NicoEFI/NicoEFI-ECU-Speeduino-mega2561/NicoEfi_GDRaceV1_Schematic_1-3.pdf

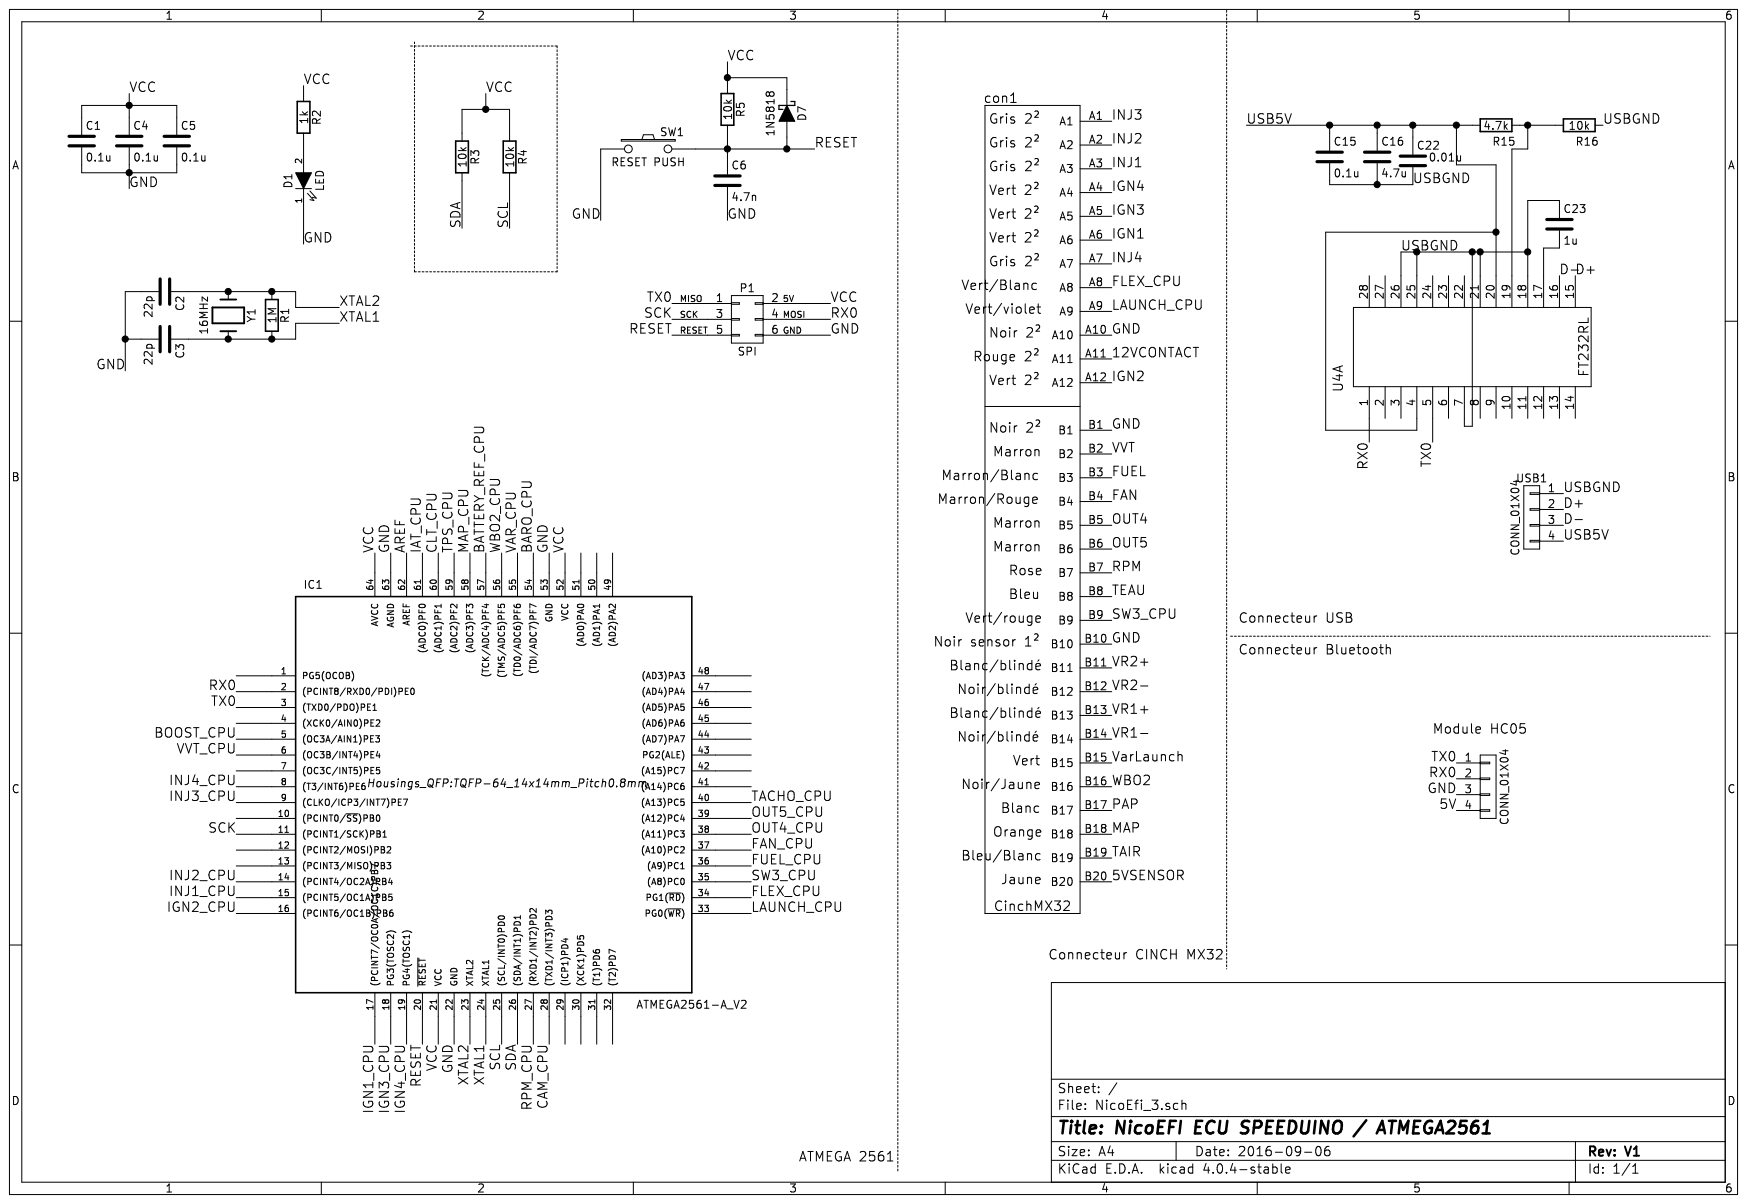
[picture p1: page 1]
