NicoEFI/NicoEFI-ECU-Speeduino-mega2561/NicoEfi_GDRaceV1_Schematic_2-3.pdf

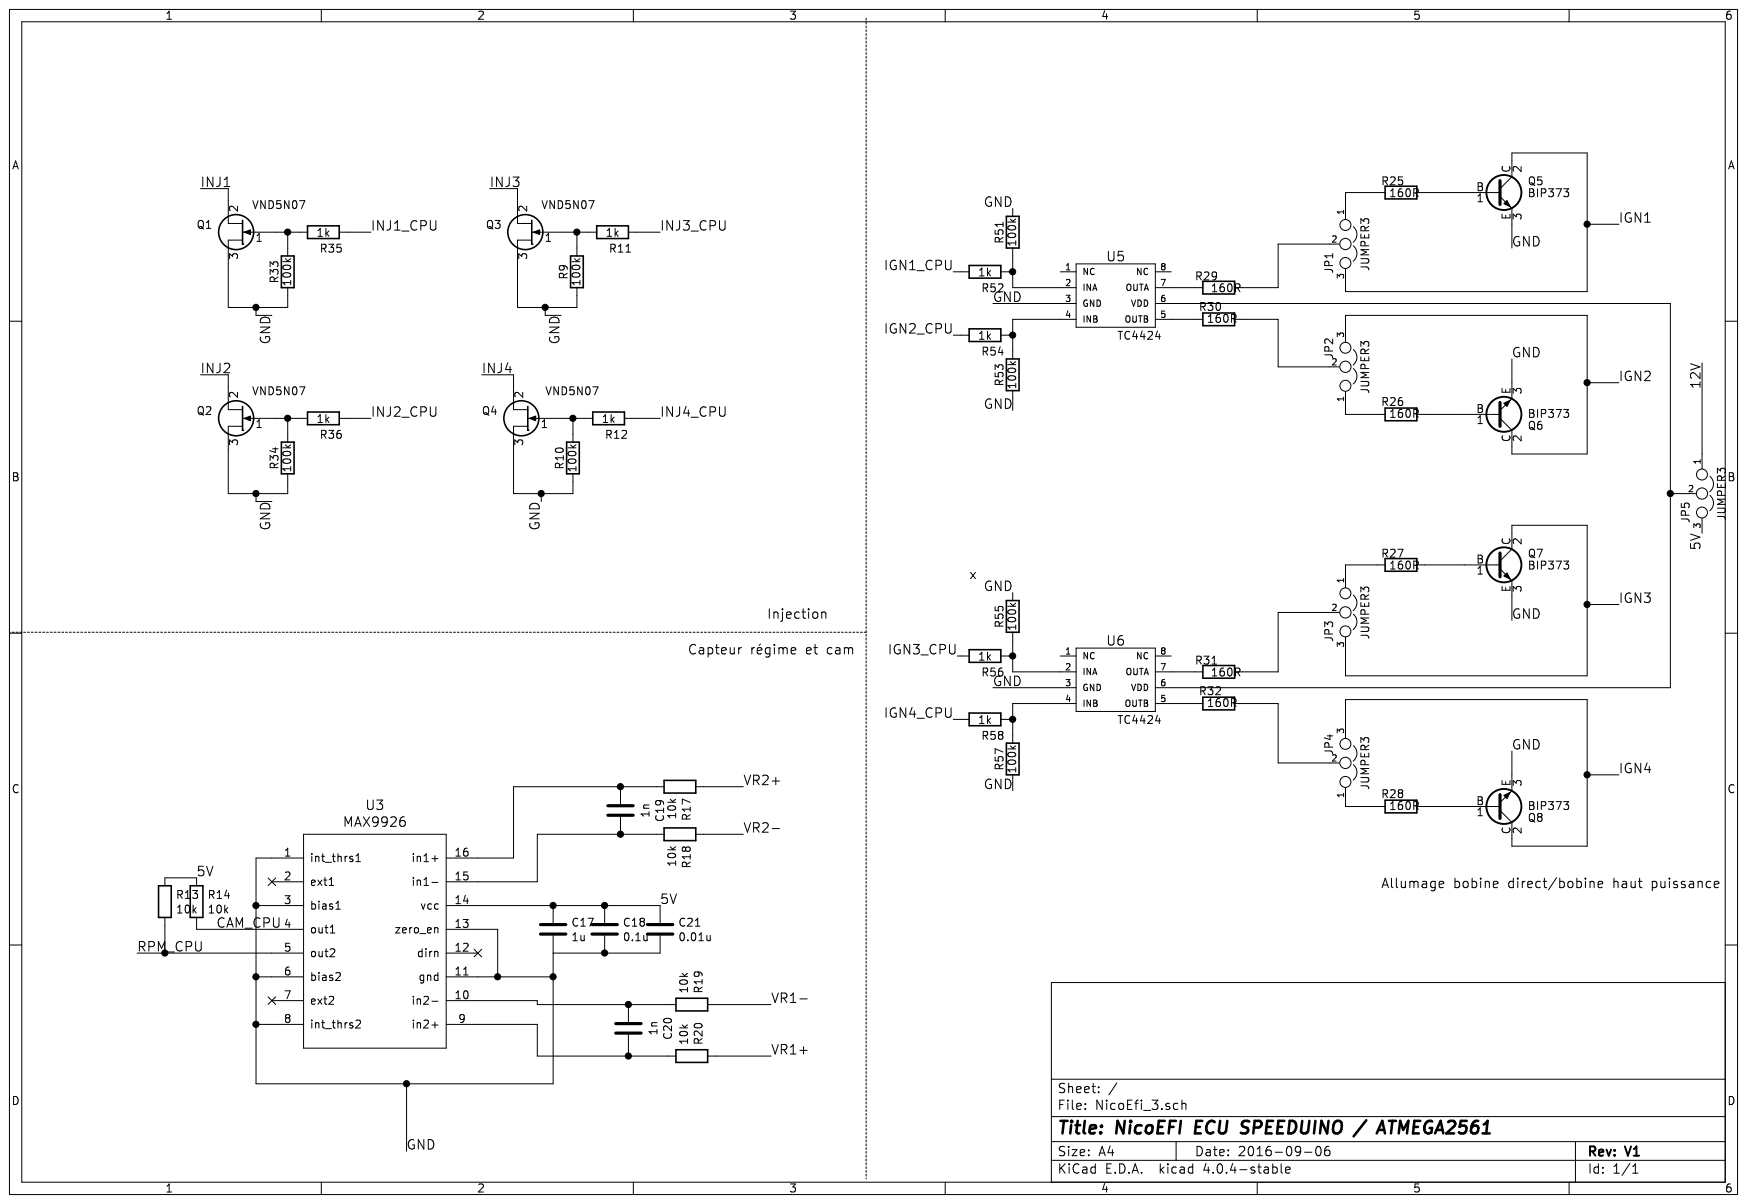
[picture p2: page 1]
