NicoEFI/NicoEFI-ECU-Speeduino-mega2561/NicoEfi_GDRaceV1_Schematic_3-3.pdf

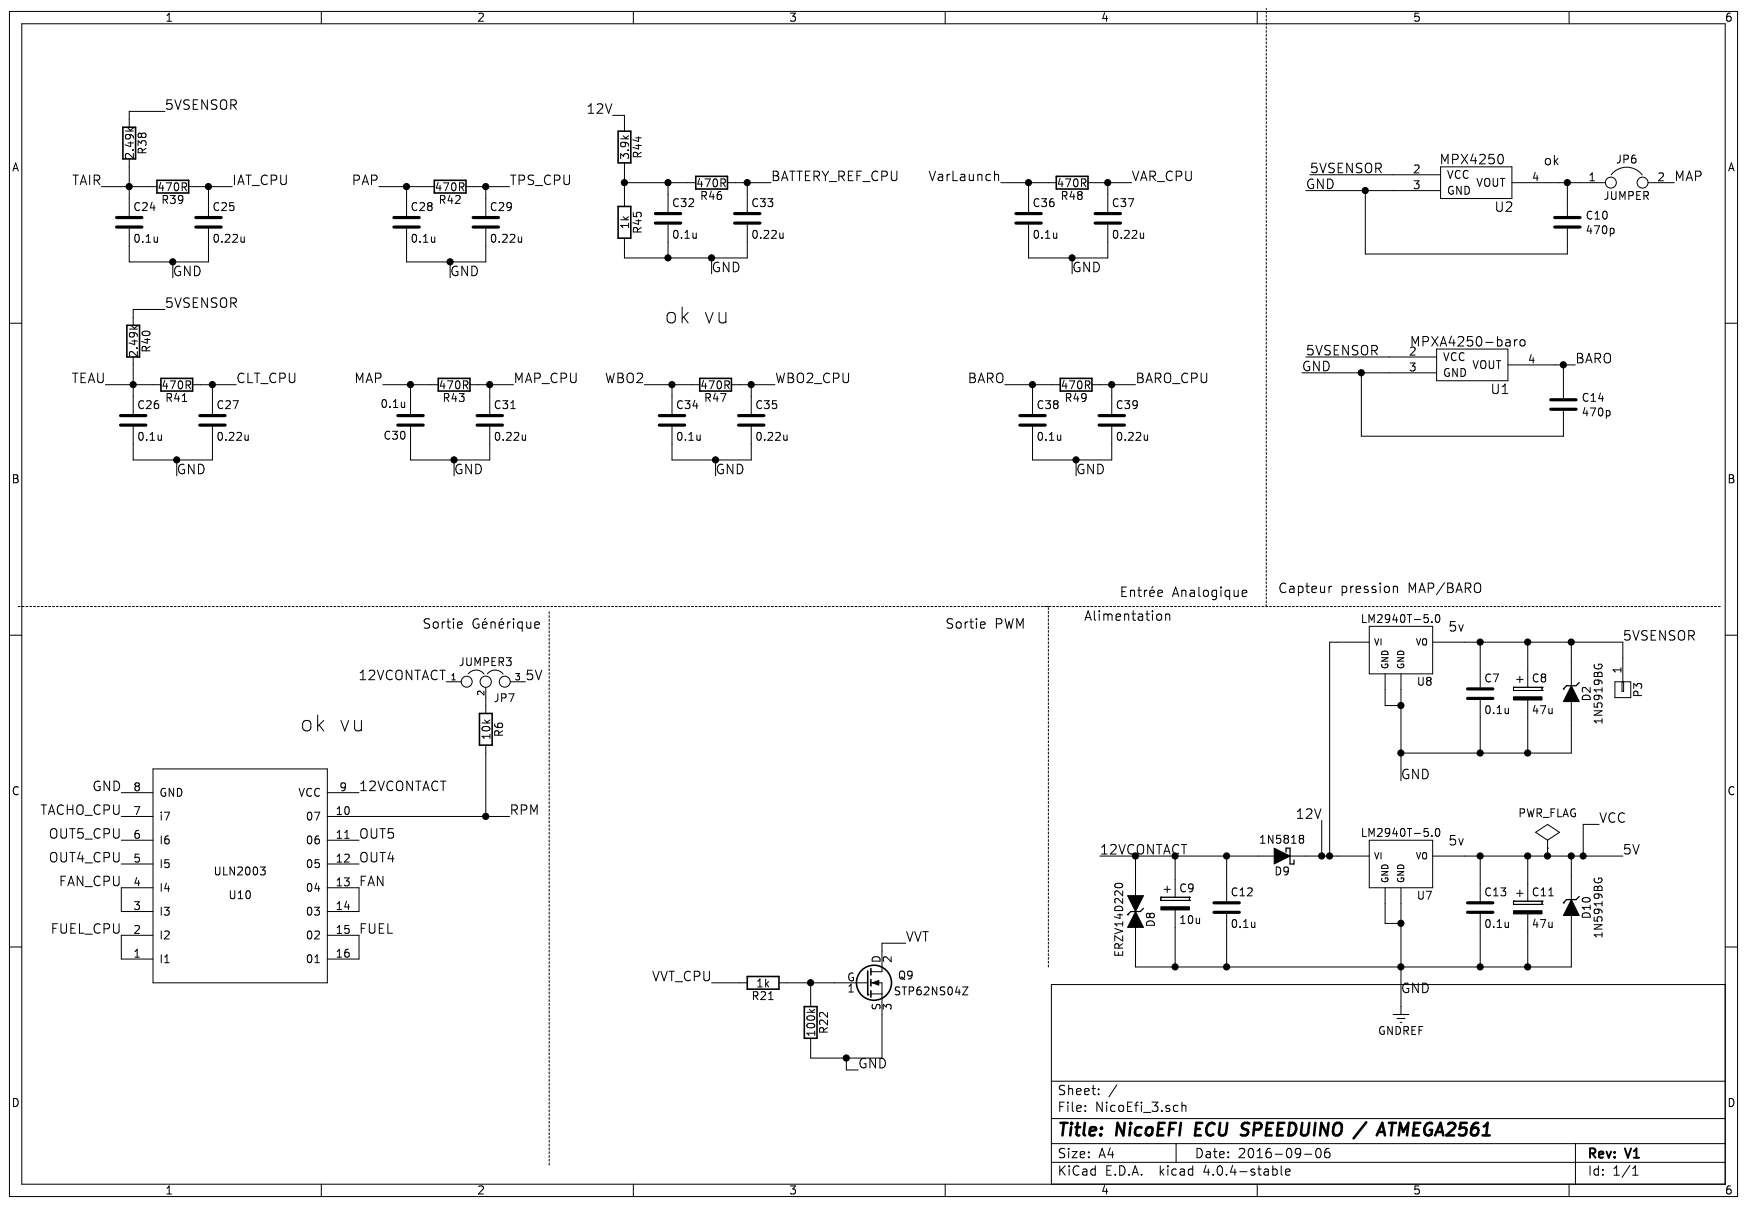
[picture p3: page 1]
