NicoEFI/NicoEFI-ECU-Speeduino-mega2561/NicoEfi_3.kicad_pcb

## KiCad design NicoEfi_3.kicad_pcb (2019-12-02)

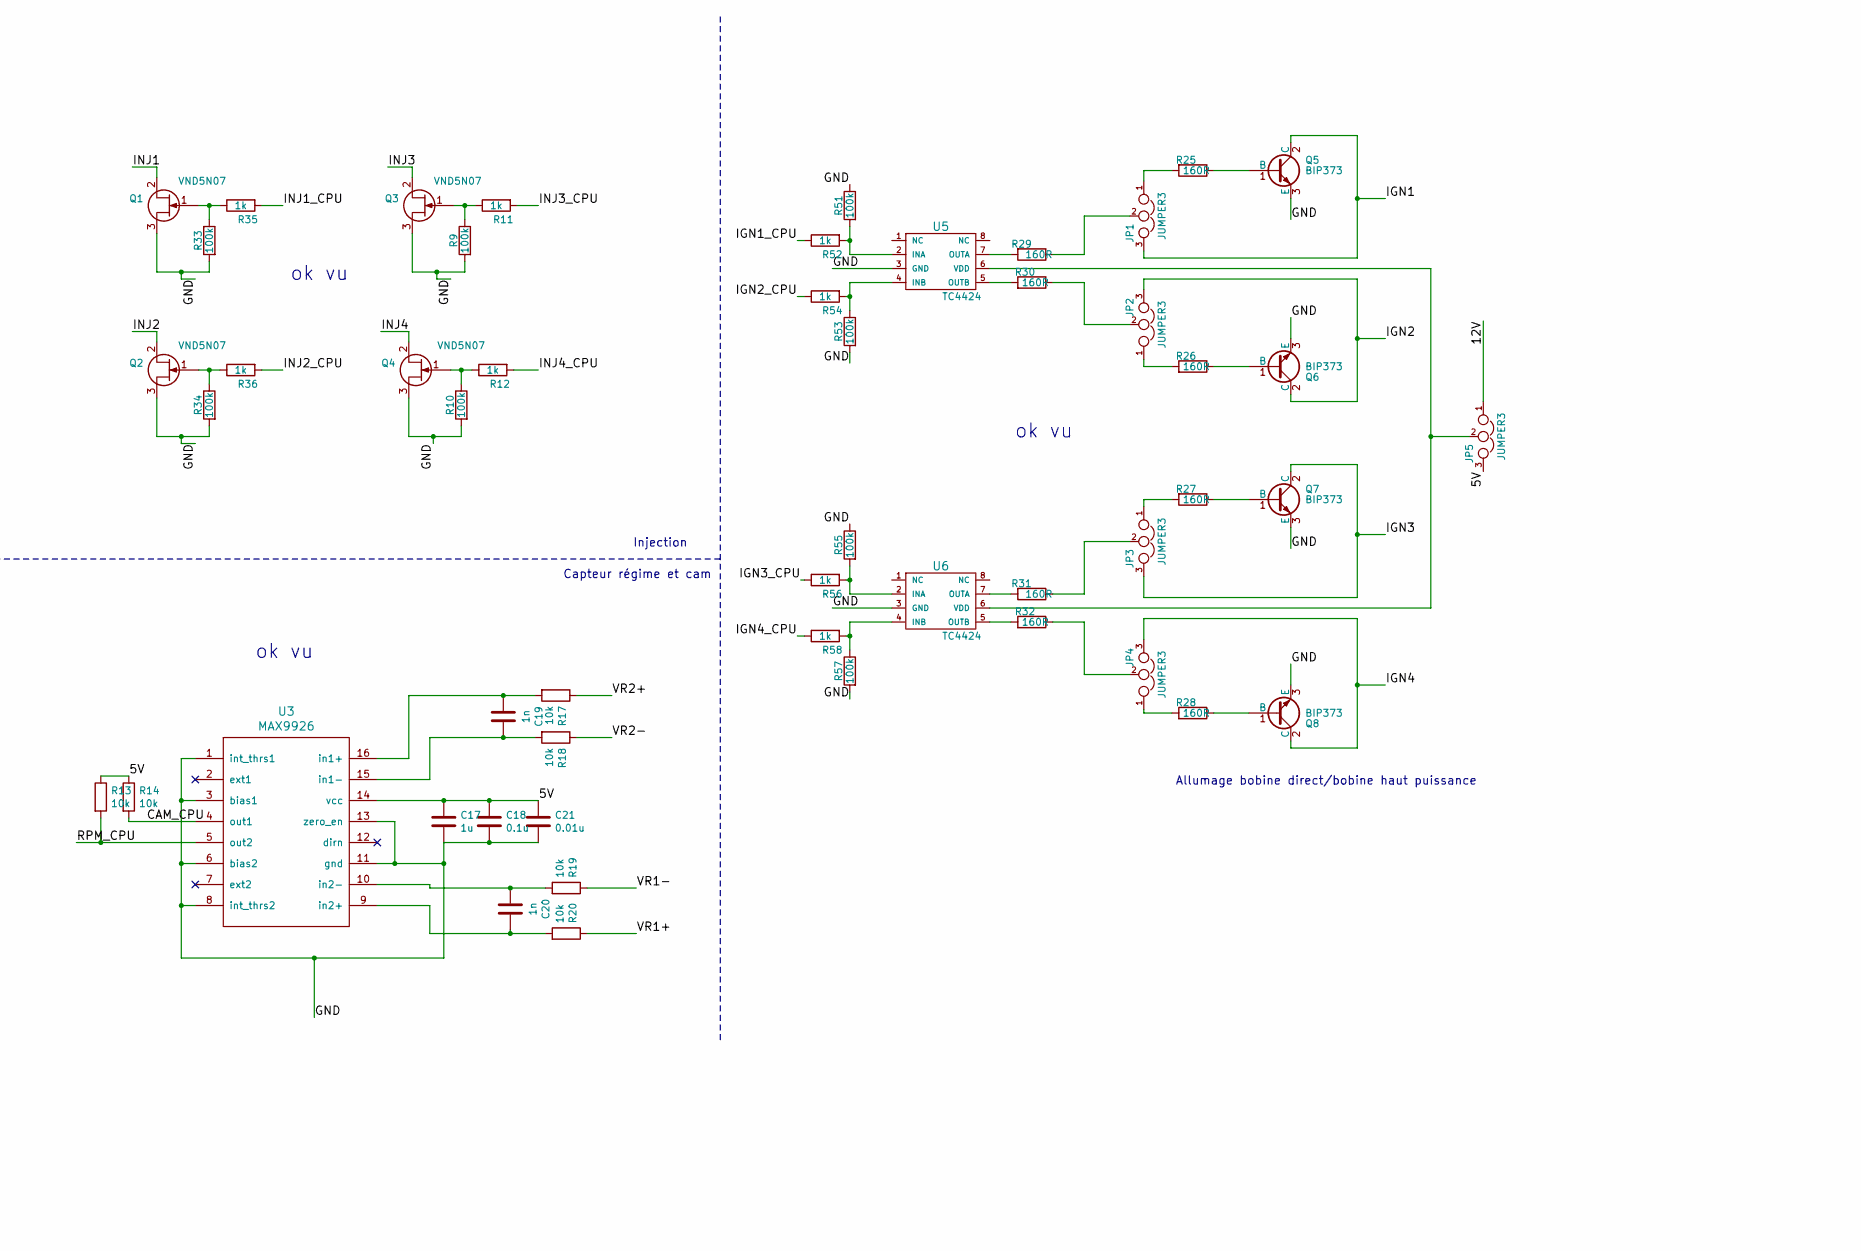
[picture p4: schematic NicoEfi_3.sch, NicoEFI ECU SPEEDUINO / ATMEGA2561, part in row 1, column 2]

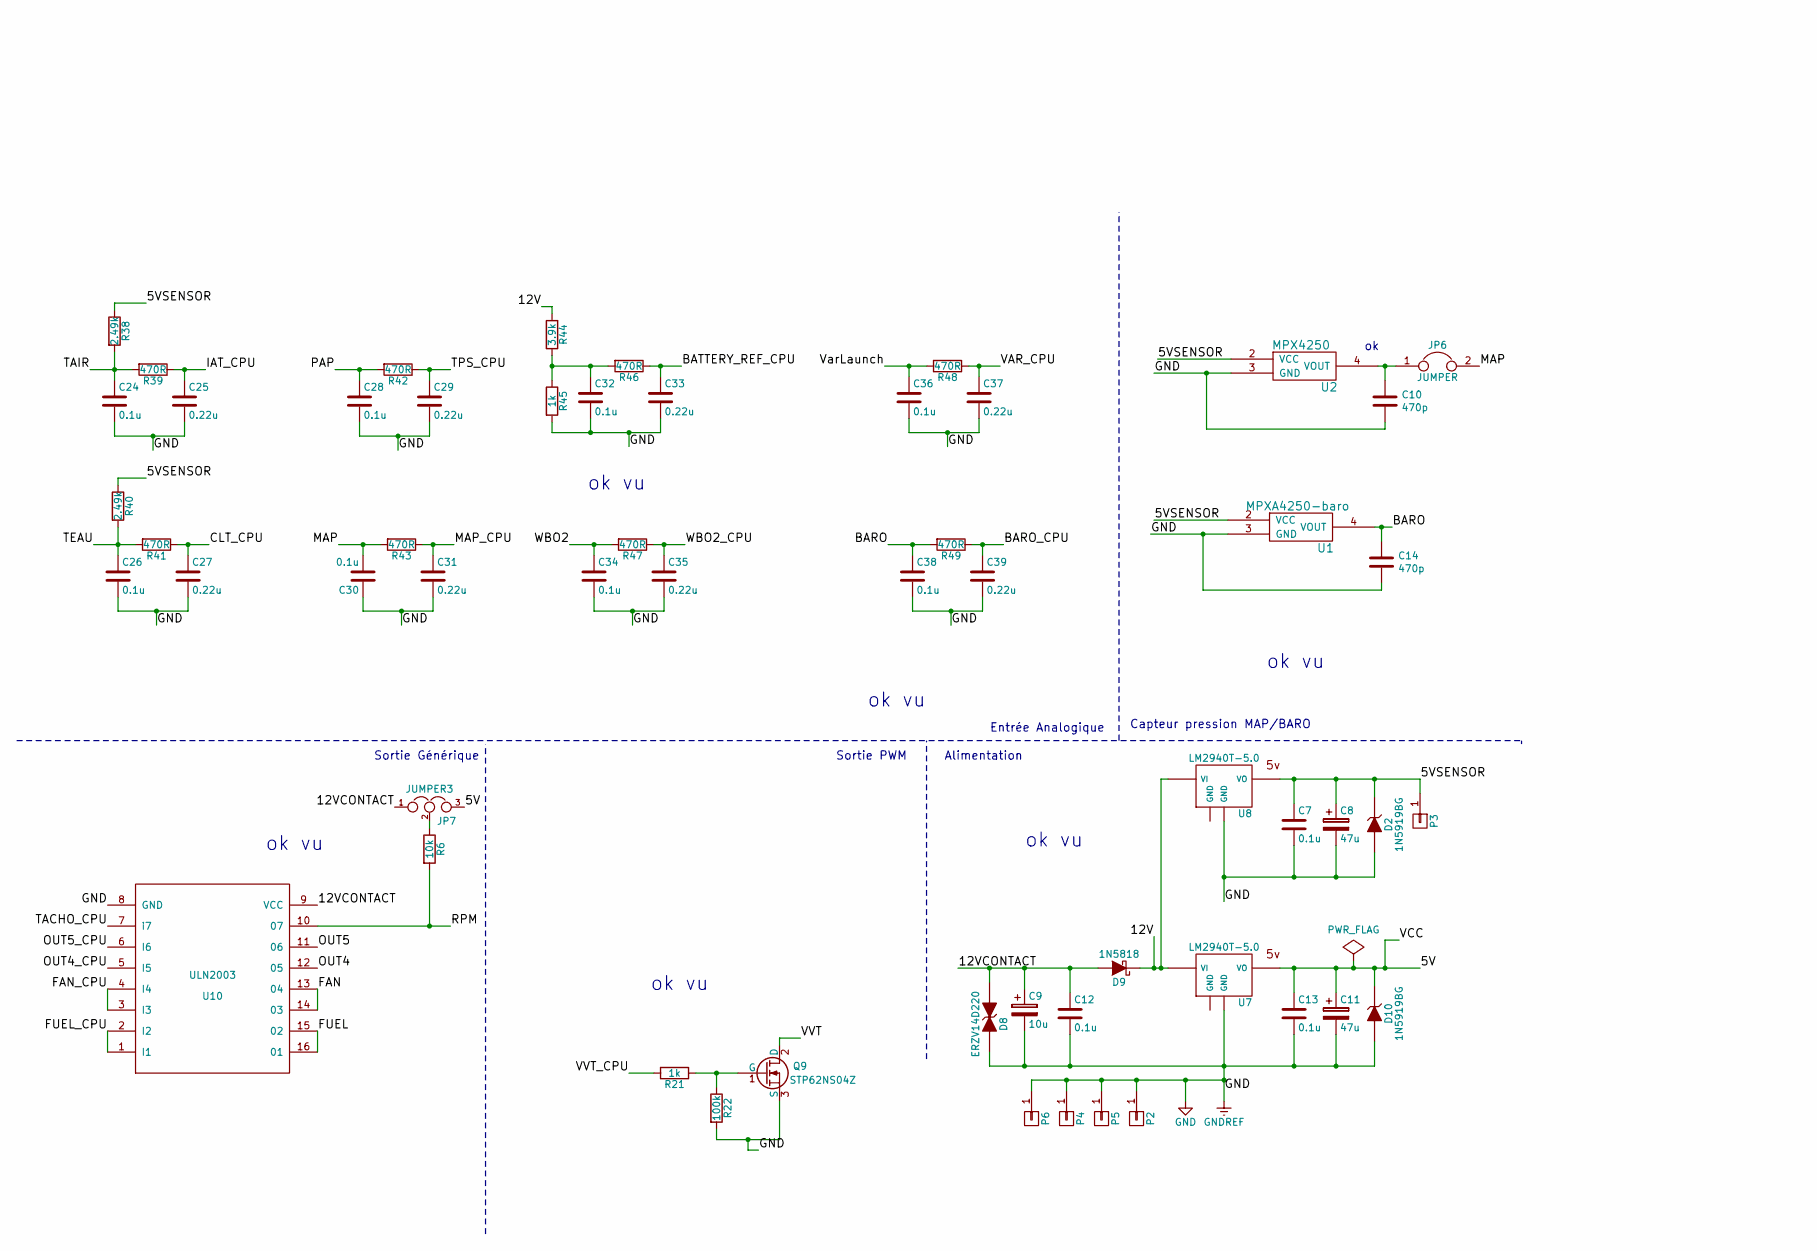
[picture p5: schematic NicoEfi_3.sch, NicoEFI ECU SPEEDUINO / ATMEGA2561, part in row 2, column 1]

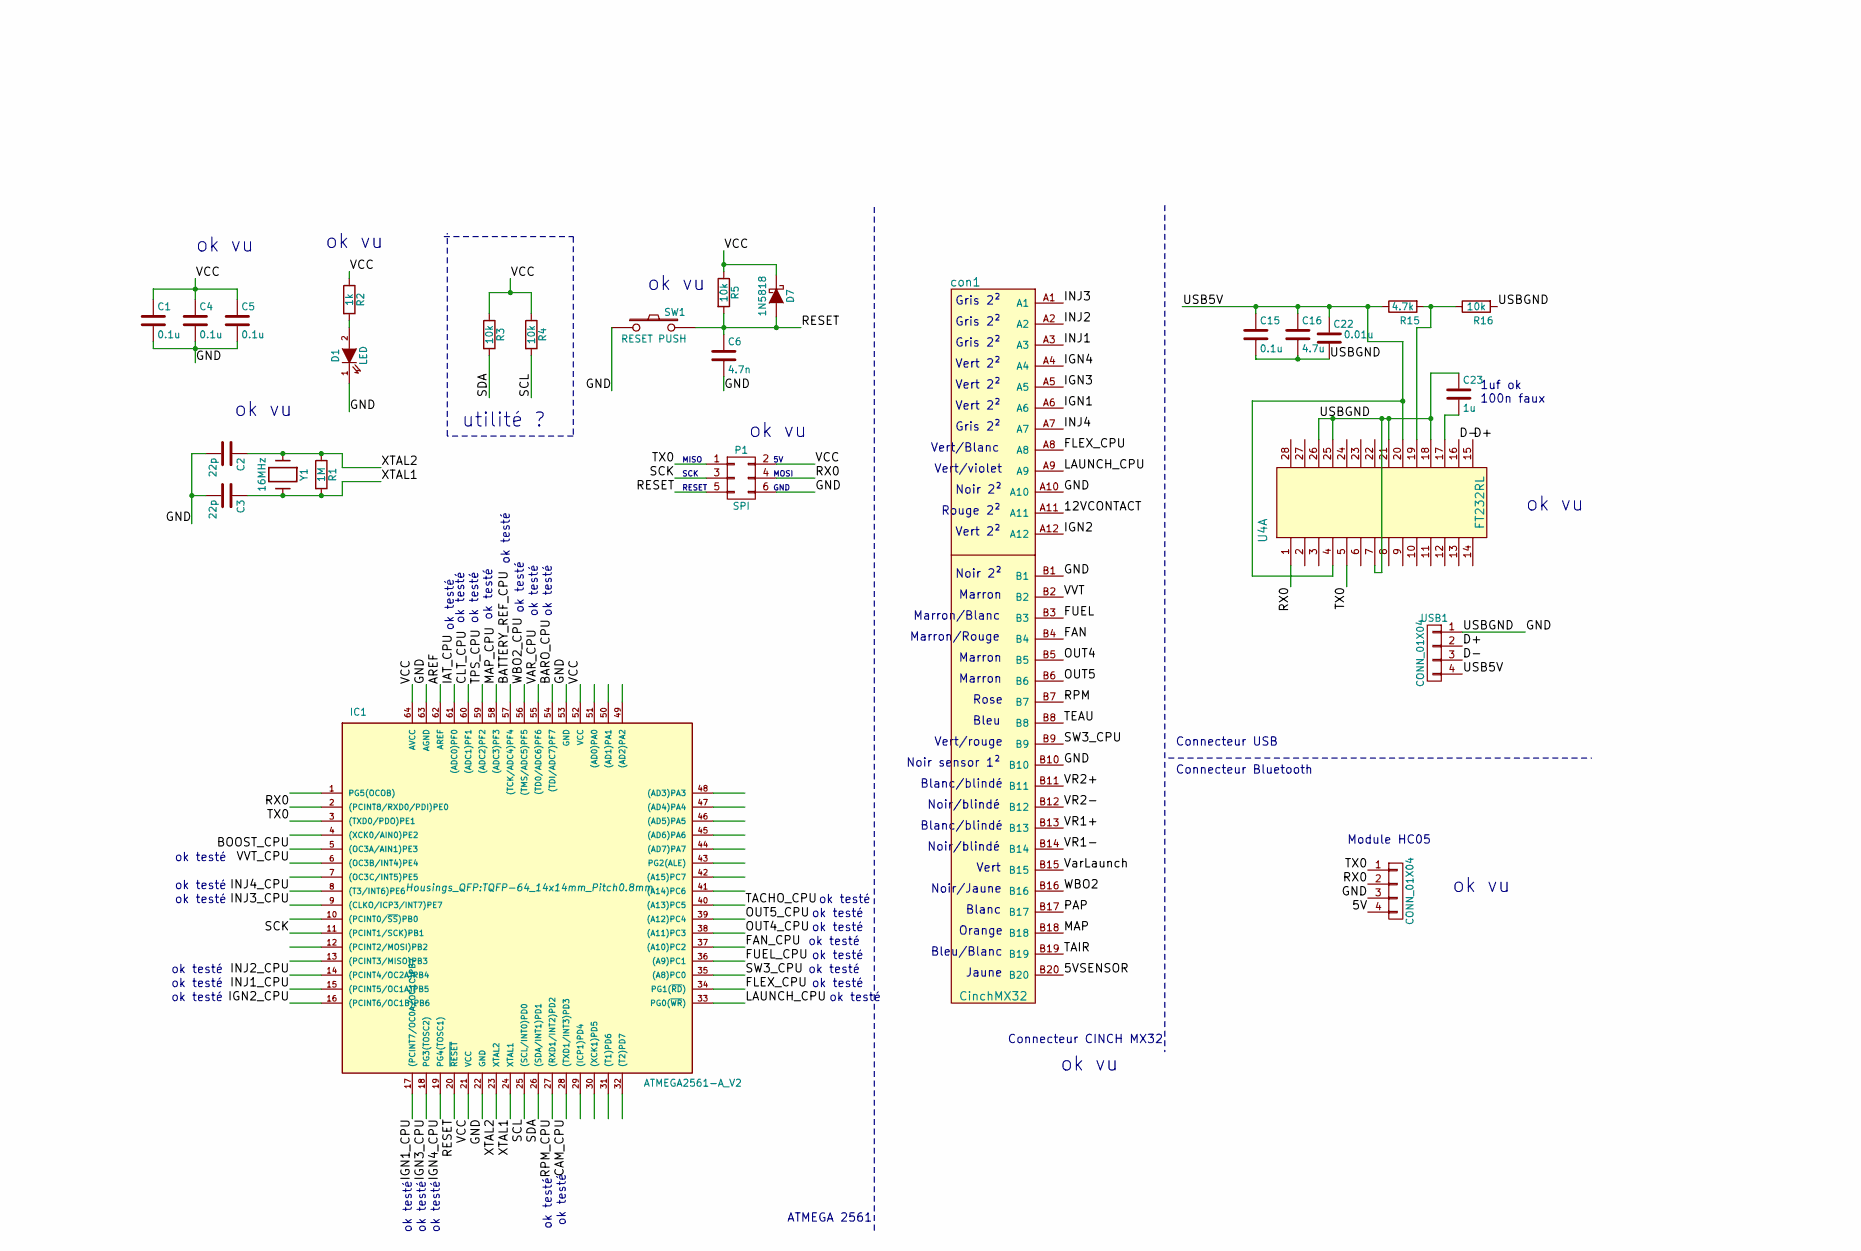
[picture p6: schematic NicoEfi_3.sch, NicoEFI ECU SPEEDUINO / ATMEGA2561, part in row 2, column 2]

Parts:
C1, C4, C5, C7, C12, C13, C15, C18, C24, C26, C28, C30, C32, C34, C36, C38: 0.1u; C_1206_HandSoldering
C2, C3: 22p; C_1206_HandSoldering
C6: 4.7n; C_1206_HandSoldering
C8, C11: 47u; TantalC_SizeC_EIA-6032
C9: 10u; TantalC_SizeC_EIA-6032
C10, C14: 470p; C_1206_HandSoldering
C16: 4.7u; C_1206_HandSoldering
C17, C23: 1u; C_1206_HandSoldering
C19, C20: 1n; C_1206_HandSoldering
C21, C22: 0.01u; C_1206_HandSoldering
C25, C27, C29, C31, C33, C35, C37, C39: 0.22u; C_1206_HandSoldering
D1: LED; LED_1206
D2, D10: 1N5919BG; do214ac
D7, D9: 1N5818; SOD-123
D8: ERZV14D220; C_Disc_D7.5_P5
HC5: CONN_01X04; Pin_Header_Straight_1x04
IC1: ATMEGA2561-A_V2; TQFP-64_14x14mm_Pitch0.8mm
JP1, JP2, JP3, JP4, JP5, JP7: JUMPER3; Pin_Header_Straight_1x03
JP6: JUMPER; Pin_Header_Straight_1x02
P1: SPI; Pin_Header_Straight_2x03
P2, P3: CONN_01X01; SolderWirePad_2x_0-8mmDrill
P4, P5, P6: CONN_01X01; SolderWirePad_single_0-8mmDrill
Q1, Q2, Q3, Q4: VND5N07
Q5, Q6, Q7, Q8: BIP373; TO-220_Neutral123_Vertical
Q9: STP62NS04Z; TO-220_Neutral123_Vertical
R1: 1M; R_1206_HandSoldering
R2, R11, R12, R21, R35, R36, R45, R52, R54, R56, R58: 1k; R_1206_HandSoldering
R3, R4, R5, R6, R13, R14, R16: 10k; R_1206_HandSoldering
R9, R10, R22, R33, R34, R51, R53, R55, R57: 100k; R_1206_HandSoldering
R15: 4.7k; R_1206_HandSoldering
R17, R18, R19, R20: 10k; R_2010_HandSoldering
R25, R26, R27, R28, R29, R30, R31, R32: 160R; R_2010_HandSoldering
R38, R40: 2.49k; R_1206_HandSoldering
R39, R41, R42, R43, R46, R47, R48, R49: 470R; R_1206_HandSoldering
R44: 3.9k; R_1206_HandSoldering
SW1: RESET PUSH; smd_push
U1: MPXA4250-baro; MPXA4250_baro
U2: MPX4250; MPXA4250
U3: MAX9926; QSOP-16_3.9x4.9mm_Pitch0.635mm
U4: FT232RL; SSOP-28_5.3x10.2mm_Pitch0.65mm
U5, U6: TC4424; SOIC-8_3.9x4.9mm_Pitch1.27mm
U7, U8: LM2940T-5.0; sot223
U10: ULN2003; SOIC-16_3.9x9.9mm_Pitch1.27mm
USB1: CONN_01X04; Pin_Header_Straight_1x04
Y1: 16MHz; Crystal_HC-49_smd_11.1_3.8
con1: CinchMX32

Connections:
/5V: C1.1, C4.1, C5.1, C11.1, C13.1, C17.1, C18.1, C21.1, D7.1 (K), D10.1 (K), HC5.4, IC1.21 (VCC), IC1.52 (VCC), IC1.64 (AVCC), JP5.3, JP7.3, P1.2, R2.1, R3.1, R4.1, R5.1, R13.1, R14.1, U3.14 (vcc), U7.3 (VO)
/5VSENSOR: C7.1, C8.1, D2.1 (K), P3.1, R38.1, R40.1, U1.2 (VCC), U2.2 (VCC), U8.3 (VO), con1.B20
/12V: D9.1 (K), JP5.1, R44.1, U7.1 (VI), U8.1 (VI)
/12VCONTACT: C9.1, C12.1, D8.1 (K), D9.2 (A), JP7.1, U10.9 (VCC), con1.A11
/BARO: C14.1, C38.1, R49.2, U1.4 (VOUT)
/BARO_CPU: C39.1, IC1.54 ((TDI/ADC7)PF7), R49.1
/BATTERY_REF_CPU: C33.1, IC1.57 ((TCK/ADC4)PF4), R46.1
/CAM_CPU: IC1.28 ((TXD1/INT3)PD3), R14.2, U3.4 (out1)
/CLT_CPU: C27.1, IC1.60 ((ADC1)PF1), R41.1
/D+: U4.15, USB1.2
/D-: U4.16, USB1.3
/FAN: U10.13 (04), U10.14 (03), con1.B4
/FAN_CPU: IC1.37 ((A10)PC2), U10.3 (I3), U10.4 (I4)
/FLEX_CPU: IC1.34 (PG1(~RD~)), con1.A8
/FUEL: U10.15 (02), U10.16 (01), con1.B3
/FUEL_CPU: IC1.36 ((A9)PC1), U10.1 (I1), U10.2 (I2)
/IAT_CPU: C25.1, IC1.61 ((ADC0)PF0), R39.1
/IGN1: JP1.3, Q5.2 (C), con1.A6
/IGN1_CPU: IC1.17 ((PCINT7/OC0A/OC1C)PB7), R52.1
/IGN2: JP2.3, Q6.2 (C), con1.A12
/IGN2_CPU: IC1.16 ((PCINT6/OC1B)PB6), R54.1
/IGN3: JP3.3, Q7.2 (C), con1.A5
/IGN3_CPU: IC1.18 (PG3(TOSC2)), R56.1
/IGN4: JP4.3, Q8.2 (C), con1.A4
/IGN4_CPU: IC1.19 (PG4(TOSC1)), R58.1
/INJ1: Q1.2 (D), con1.A3
/INJ1_CPU: IC1.15 ((PCINT5/OC1A)PB5), R35.2
/INJ2: Q2.2 (D), con1.A2
/INJ2_CPU: IC1.14 ((PCINT4/OC2A)PB4), R36.2
/INJ3: Q3.2 (D), con1.A1
/INJ3_CPU: IC1.9 ((CLKO/ICP3/INT7)PE7), R11.2
/INJ4: Q4.2 (D), con1.A7
/INJ4_CPU: IC1.8 ((T3/INT6)PE6), R12.2
/LAUNCH_CPU: IC1.33 (PG0(~WR~)), con1.A9
/MAP: C30.2, JP6.2, R43.2, con1.B18
/MAP_CPU: C31.1, IC1.58 ((ADC3)PF3), R43.1
/OUT4: U10.12 (05), con1.B5
/OUT4_CPU: IC1.38 ((A11)PC3), U10.5 (I5)
/OUT5: U10.11 (06), con1.B6
/OUT5_CPU: IC1.39 ((A12)PC4), U10.6 (I6)
/PAP: C28.1, R42.2, con1.B17
/RESET: C6.1, D7.2 (A), IC1.20 (~RESET), P1.5, R5.2, SW1.2
/RPM: R6.2, U10.10 (07), con1.B7
/RPM_CPU: IC1.27 ((RXD1/INT2)PD2), R13.2, U3.5 (out2)
/RX0: HC5.2, IC1.2 ((PCINT8/RXD0/PDI)PE0), P1.4, U4.1
/SCK: IC1.11 ((PCINT1/SCK)PB1), P1.3
/SCL: IC1.25 ((SCL/INT0)PD0), R4.2
/SDA: IC1.26 ((SDA/INT1)PD1), R3.2
/SW3_CPU: IC1.35 ((A8)PC0), con1.B9
/TACHO_CPU: IC1.40 ((A13)PC5), U10.7 (i7)
/TAIR: C24.1, R38.2, R39.2, con1.B19
/TEAU: C26.1, R40.2, R41.2, con1.B8
/TPS_CPU: C29.1, IC1.59 ((ADC2)PF2), R42.1
/TX0: HC5.1, IC1.3 ((TXD0/PDO)PE1), P1.1, U4.5
/USB5V: C15.1, C16.1, C22.1, R15.1, U4.4, U4.20, USB1.4
/VAR_CPU: C37.1, IC1.55 ((TD0/ADC6)PF6), R48.1
/VR1+: R20.1, con1.B13
/VR1-: R19.1, con1.B14
/VR2+: R17.1, con1.B11
/VR2-: R18.1, con1.B12
/VVT: Q9.2 (D), con1.B2
/VVT_CPU: IC1.6 ((OC3B/INT4)PE4), R21.2
/VarLaunch: C36.1, R48.2, con1.B15
/WBO2: C34.1, R47.2, con1.B16
/WBO2_CPU: C35.1, IC1.56 ((TMS/ADC5)PF5), R47.1
/XTAL1: C3.1, IC1.24 (XTAL1), R1.2, Y1.2
/XTAL2: C2.1, IC1.23 (XTAL2), R1.1, Y1.1
GND: C1.2, C2.2, C3.2, C4.2, C5.2, C6.2, C7.2, C8.2, C9.2, C10.2, C11.2, C12.2, C13.2, C14.2, C15.2, C16.2, C17.2, C18.2, C21.2, C22.2, C23.1, C24.2, C25.2, C26.2, C27.2, C28.2, C29.2, C30.1, C31.2, C32.2, C33.2, C34.2, C35.2, C36.2, C37.2, C38.2, C39.2, D1.1 (K), D2.2 (A), D8.2 (A), D10.2 (A), HC5.3, IC1.22 (GND), IC1.53 (GND), IC1.63 (AGND), P1.6, P2.1, P4.1, P5.1, P6.1, Q1.3 (S), Q2.3 (S), Q3.3 (S), Q4.3 (S), Q5.3 (E), Q6.3 (E), Q7.3 (E), Q8.3 (E), Q9.3 (S), R9.2, R10.2, R16.2, R22.2, R33.2, R34.2, R45.2, R51.1, R53.2, R55.1, R57.2, SW1.1, U1.3 (GND), U2.3 (GND), U3.1 (int_thrs1), U3.3 (bias1), U3.6 (bias2), U3.8 (int_thrs2), U3.11 (gnd), U3.13 (zero_en), U4.7, U4.18, U4.21, U4.25, U4.26, U5.3 (GND), U6.3 (GND), U7.2 (GND), U8.2 (GND), U10.8 (GND), USB1.1, con1.A10, con1.B1, con1.B10; also elsewhere on the board
unnamed: C10.1, JP6.1, U2.4 (VOUT)
unnamed: C19.1, R18.2, U3.15 (in1-)
unnamed: C19.2, R17.2, U3.16 (in1+)
unnamed: C20.1, R19.2, U3.10 (in2-)
unnamed: C20.2, R20.2, U3.9 (in2+)
unnamed: C23.2, U4.17
unnamed: C32.1, R44.2, R45.1, R46.2
unnamed: D1.2 (A), R2.2
unnamed: JP1.1, R25.2
unnamed: JP1.2, R29.1
unnamed: JP2.1, R26.2
unnamed: JP2.2, R30.1
unnamed: JP3.1, R27.2
unnamed: JP3.2, R31.1
unnamed: JP4.1, R28.2
unnamed: JP4.2, R32.1
unnamed: JP5.2, U5.6 (VDD), U6.6 (VDD)
unnamed: JP7.2, R6.1
unnamed: Q1.1 (G), R33.1, R35.1
unnamed: Q2.1 (G), R34.1, R36.1
unnamed: Q3.1 (G), R9.1, R11.1
unnamed: Q4.1 (G), R10.1, R12.1
unnamed: Q5.1 (B), R25.1
unnamed: Q6.1 (B), R26.1
unnamed: Q7.1 (B), R27.1
unnamed: Q8.1 (B), R28.1
unnamed: Q9.1 (G), R21.1, R22.1
unnamed: R15.2, R16.1, U4.19
unnamed: R29.2, U5.7 (OUTA)
unnamed: R30.2, U5.5 (OUTB)
unnamed: R31.2, U6.7 (OUTA)
unnamed: R32.2, U6.5 (OUTB)
unnamed: R51.2, R52.2, U5.2 (INA)
unnamed: R53.1, R54.2, U5.4 (INB)
unnamed: R55.2, R56.2, U6.2 (INA)
unnamed: R57.1, R58.2, U6.4 (INB)

Notes on the sheet:
Capteur pression MAP/BARO
Injection
Capteur régime et cam
Allumage bobine direct/bobine haut puissance
MISO
MOSI
GND
SCK
RESET
Connecteur USB
Connecteur Bluetooth
Module HC05
Connecteur CINCH MX32
ATMEGA 2561
Alimentation
Sortie PWM
Sortie Générique
Entrée Analogique
ok vu
utilité ?
Gris 2²
Rose
Vert 2²
Rouge 2²
Noir 2²
Jaune
Noir sensor 1²
Marron/Rouge
Marron/Blanc
Marron
Vert/violet
Vert/Blanc
Bleu/Blanc
Bleu
Orange
Blanc
Vert
Blanc/blindé
Noir/blindé
Vert/rouge
Noir/Jaune
1uf ok 100n faux
ok testé

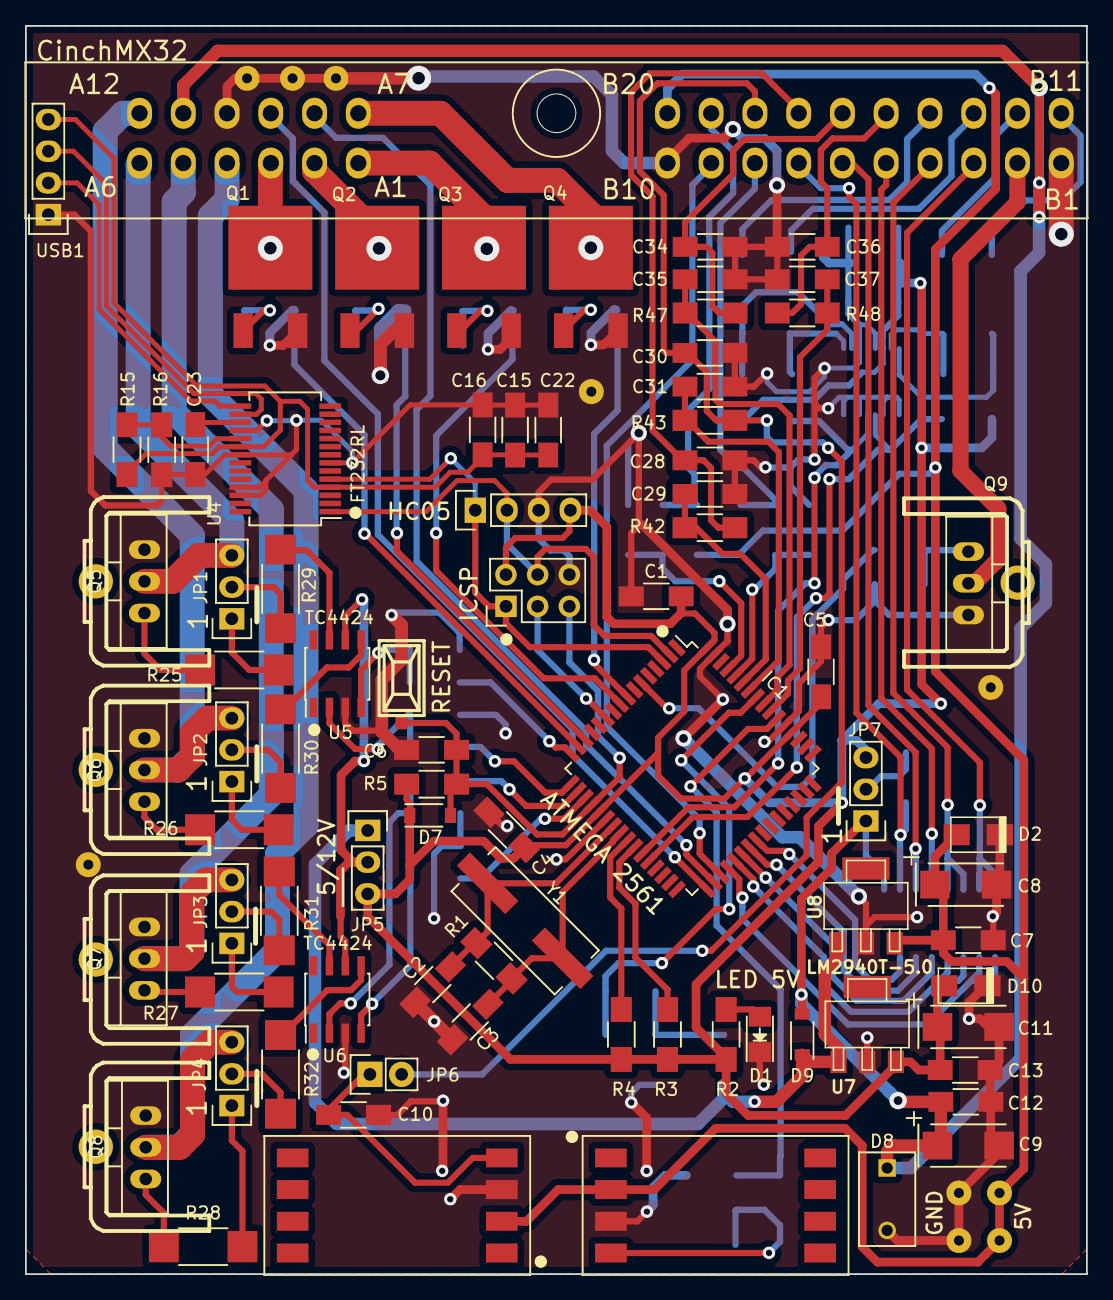
[picture p7: board NicoEfi_3.kicad_pcb from above]

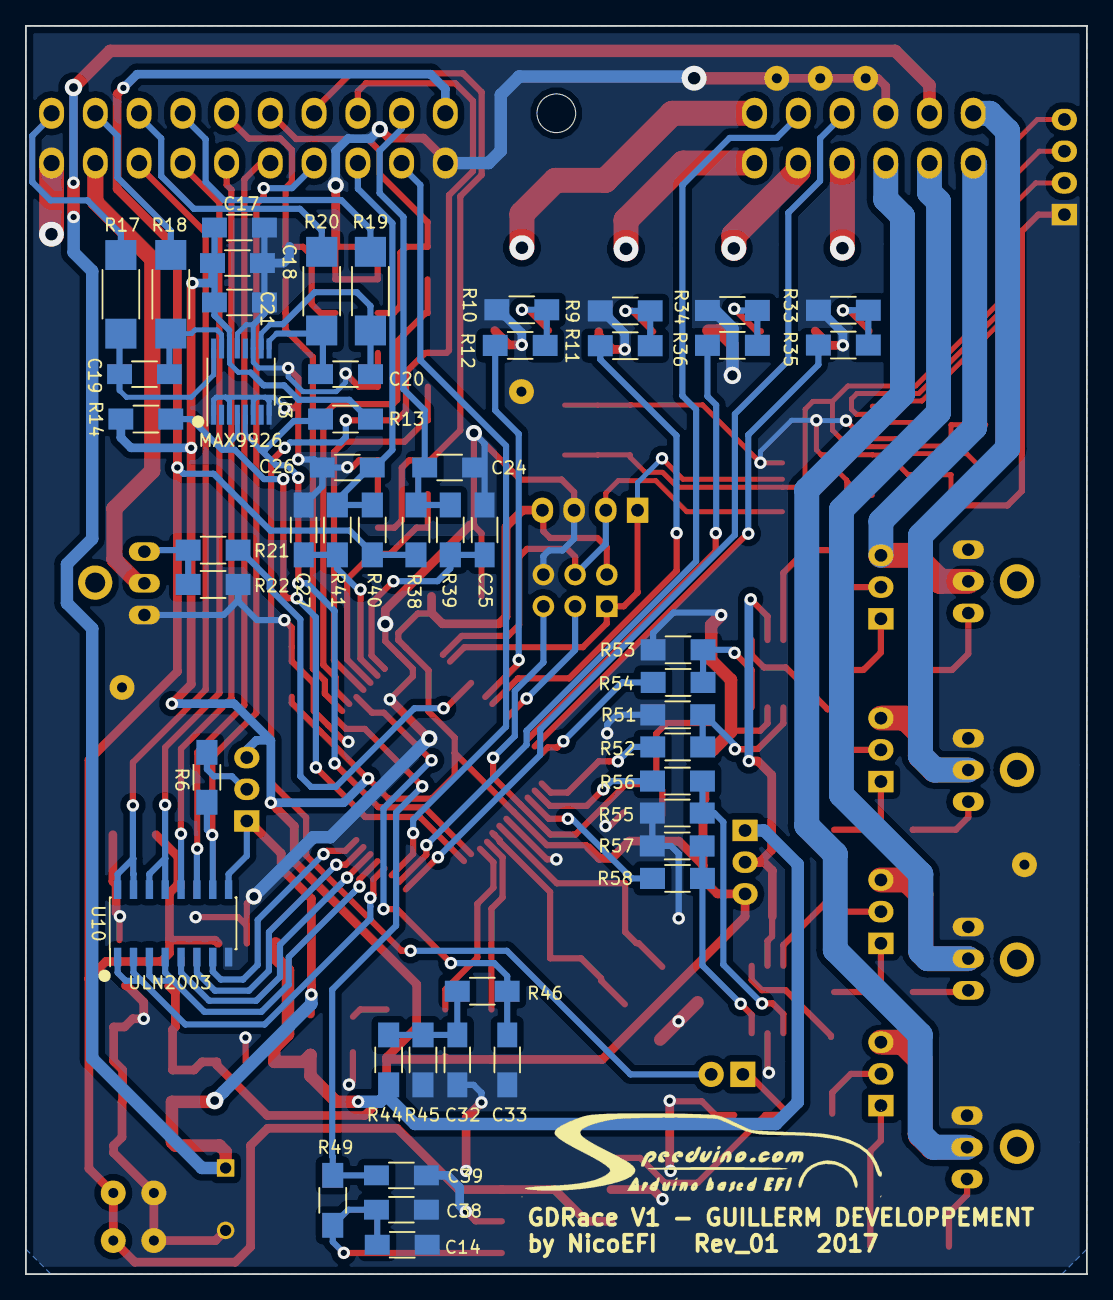
[picture p8: board NicoEfi_3.kicad_pcb from below]

Board: 2 copper layers, 85.0 x 100.0 mm, 142 parts (49 on the bottom side), 104 nets.

Other parts of the board:
P4#2, P4#3, P4#4: CONN_01X01; SolderWirePad_single_0-8mmDrill
hs_5770, hs_5770#2, hs_5770#3, hs_5770#4, hs_5770#5: VAL***; hs_5771

Their connections:
GND: P4#2.1, P4#3.1, P4#4.1; also elsewhere on the board
